higherSentinel/Meshy-Tron/hardware/meshy-tron.pdf

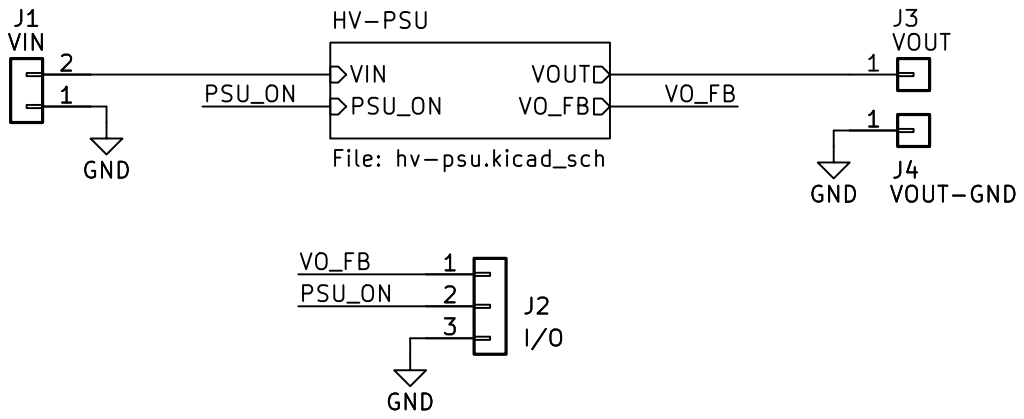
[picture p1: page 1]

File: meshy-tron.kicad_sch Sheet: / AVLabs

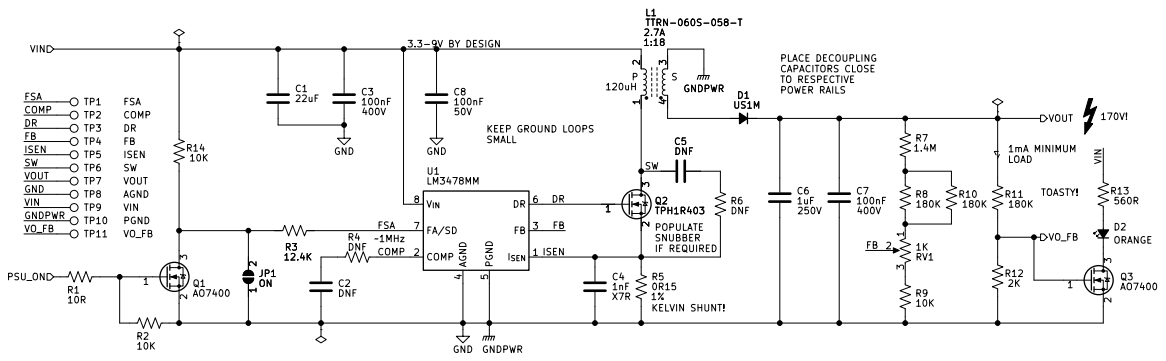
[picture p2: page 2]

File: hv-psu.kicad_sch Sheet: /HV-PSU/ AVLabs
