higherSentinel/Meshy-Tron/hardware/meshy-tron.kicad_pcb

## KiCad design hardware/meshy-tron.kicad_pcb (2022-12-14)

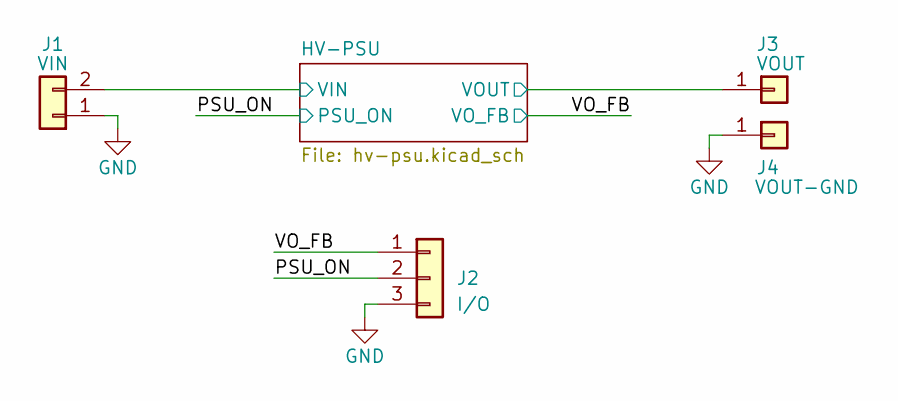
[picture p3: schematic meshy-tron.kicad_sch, Meshytron]

Parts:
J1: VIN; PinHeader_1x02_P2.54mm_Vertical
J2: I/O; PinHeader_1x03_P2.54mm_Vertical
J3: VOUT; PinHeader_1x01_P2.54mm_Vertical
J4: VOUT-GND; PinHeader_1x01_P2.54mm_Vertical

Connections:
/HV-PSU/VIN: J1.2; also elsewhere on the board
/HV-PSU/VOUT: J3.1; also elsewhere on the board
/PSU_ON: J2.2; also elsewhere on the board
/VO_FB: J2.1; also elsewhere on the board
GND: J1.1, J2.3, J4.1; also elsewhere on the board

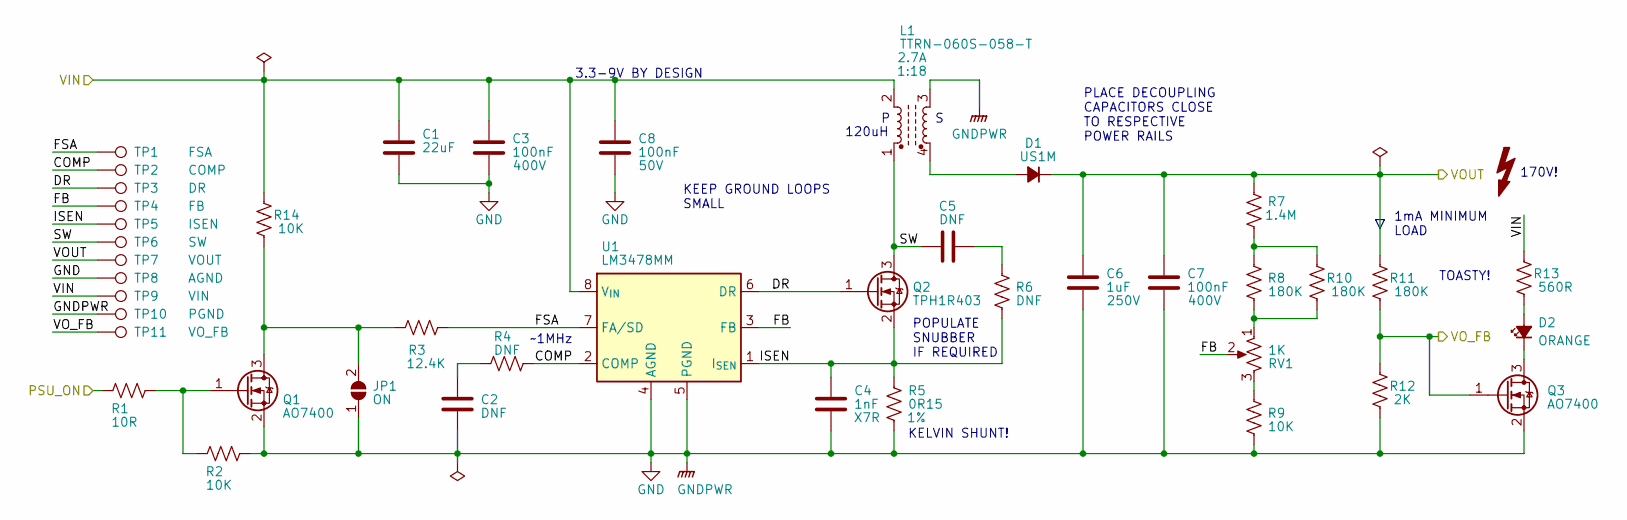
[picture p4: schematic hv-psu.kicad_sch, Meshytron]

Parts:
C1: 22uF; C_0603_1608Metric_Pad1.08x0.95mm_HandSolder; MPN CL31A226KAHNNNE; LCSC C12891
C2, C5: DNF; C_0603_1608Metric_Pad1.08x0.95mm_HandSolder
C3, C7: 100nF; C_1206_3216Metric_Pad1.33x1.80mm_HandSolder; Voltage 400V; MPN FM31X104K251EEG; LCSC C365814
C4: 1nF; C_0603_1608Metric_Pad1.08x0.95mm_HandSolder; MPN CL10B102KB8NNNC; LCSC C1588
C6: 1uF; C_1812_4532Metric_Pad1.57x3.40mm_HandSolder; Voltage 250V; Tolerance X7R; MPN FS43X105K251EGG; LCSC C381468
C8: 100nF; C_0603_1608Metric_Pad1.08x0.95mm_HandSolder; Voltage 50V; MPN 0603B104K500NT; LCSC C30926
D1: US1M; D_SMA_Handsoldering; MPN US1M; LCSC C412437
D2: ORANGE; LED_0805_2012Metric_Pad1.15x1.40mm_HandSolder; MPN SZYY0805O; LCSC C434437
JP1: ON; SolderJumper-2_P1.3mm_Open_RoundedPad1.0x1.5mm
L1: TTRN-060S-058-T; MPN TTRN-060S-058-T
Q1, Q3: AO7400; SOT-323_SC-70_Handsoldering; MPN AO7400-VB; LCSC C879165
Q2: TPH1R403; SOP-ADVANCED; MPN TPH1R403NL; LCSC C83440
R1: 10R; R_0603_1608Metric_Pad0.98x0.95mm_HandSolder; MPN 0603WAF100JT5E; LCSC C22859
R2, R9, R14: 10K; R_0603_1608Metric_Pad0.98x0.95mm_HandSolder; MPN RC0603JR-0710KL; LCSC C99198
R3: 12.4K; R_0603_1608Metric_Pad0.98x0.95mm_HandSolder; MPN RS-03K1242FT; LCSC C310267
R4, R6: DNF; R_0603_1608Metric_Pad0.98x0.95mm_HandSolder
R5: 0R15; R_1206_3216Metric_Pad1.30x1.75mm_HandSolder; Tolerance 1%; MPN RL1206FR-070R15L; LCSC C327070
R7: 1.4M; R_0603_1608Metric_Pad0.98x0.95mm_HandSolder; MPN CR1206F41404G; LCSC C3037104
R8, R10, R11: 180K; R_1210_3225Metric_Pad1.30x2.65mm_HandSolder; MPN FRC1210J184-TS; LCSC C2960705
R12: 2K; R_0603_1608Metric_Pad0.98x0.95mm_HandSolder; MPN 0603WAF2001T5E; LCSC C22975
R13: 560R; R_0603_1608Metric_Pad0.98x0.95mm_HandSolder; MPN 0805W8F5600T5E; LCSC C28636
RV1: 1K; Potentiometer_Bourns_3224W_Vertical; MPN BOURNS 3224W-1-102E; LCSC C50204
TP1: FSA; TestPoint_Pad_D1.0mm
TP2: COMP; TestPoint_Pad_D1.0mm
TP3: DR; TestPoint_Pad_D1.0mm
TP4: FB; TestPoint_Pad_D1.0mm
TP5: ISEN; TestPoint_Pad_D1.0mm
TP6: SW; TestPoint_Pad_D1.0mm
TP7: VOUT; TestPoint_Pad_D1.0mm
TP8: AGND; TestPoint_Pad_D1.0mm
TP9: VIN; TestPoint_Pad_D1.0mm
TP10: PGND; TestPoint_Pad_D1.0mm
TP11: VO_FB; TestPoint_Pad_D1.0mm
U1: LM3478MM; VSSOP-8_3.0x3.0mm_P0.65mm; MPN LM3478MMX/NOPB; LCSC C404045

Connections:
/HV-PSU/COMP: R4.2, TP2.1, U1.2 (COMP)
/HV-PSU/DR: Q2.1 (G), TP3.1, U1.6 (DR)
/HV-PSU/FB: RV1.2, TP4.1, U1.3 (FB)
/HV-PSU/FSA: R3.2, TP1.1, U1.7 (FA/SD)
/HV-PSU/ISEN: C4.1, Q2.2 (S), R5.2, R6.1, TP5.1, U1.1 (I_{SEN})
/HV-PSU/SW: C5.1, L1.1, Q2.3 (D), TP6.1
/HV-PSU/VIN: C1.1, C3.1, C8.1, L1.2, R13.2, R14.2, TP9.1, U1.8 (V_{IN}); also elsewhere on the board
/HV-PSU/VOUT: C6.1, C7.1, D1.1 (K), R7.1, R11.2, TP7.1; also elsewhere on the board
/PSU_ON: R1.2; also elsewhere on the board
/VO_FB: Q3.1 (G), R11.1, R12.2, TP11.1; also elsewhere on the board
GND: C1.2, C2.2, C3.2, C4.2, C6.2, C7.2, C8.2, JP1.1 (A), L1.3, Q1.2 (S), Q3.2 (S), R2.1, R5.1, R9.1, R12.1, TP8.1, TP10.1, U1.4 (AGND), U1.5 (PGND); also elsewhere on the board
unnamed: C2.1, R4.1
unnamed: C5.2, R6.2
unnamed: D1.2 (A), L1.4
unnamed: D2.1 (K), Q3.3 (D)
unnamed: D2.2 (A), R13.1
unnamed: JP1.2 (B), Q1.3 (D), R3.1, R14.1
unnamed: Q1.1 (G), R1.1, R2.2
unnamed: R9.2, RV1.3
unnamed: R8.1, R10.1, RV1.1
unnamed: R7.2, R8.2, R10.2

Notes on the sheet:
TOASTY!
PLACE DECOUPLING CAPACITORS CLOSE TO RESPECTIVE POWER RAILS
KELVIN SHUNT!
~1MHz
170V!
120uH
3.3-9V BY DESIGN
POPULATE SNUBBER IF REQUIRED
1mA MINIMUM LOAD
KEEP GROUND LOOPS SMALL

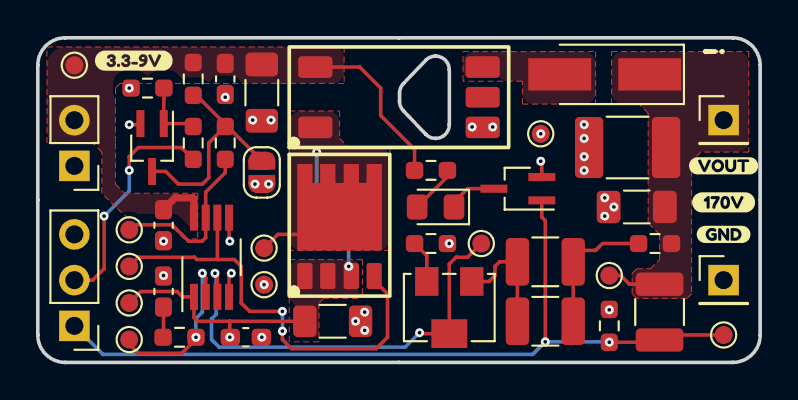
[picture p5: board meshy-tron.kicad_pcb from above]

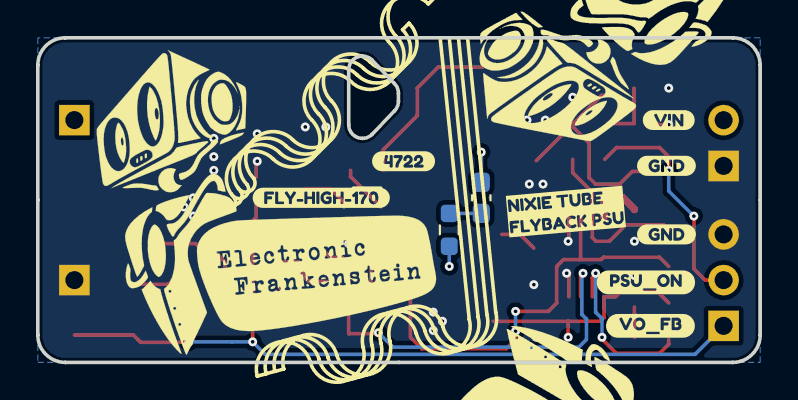
[picture p6: board meshy-tron.kicad_pcb from below]

Board: 2 copper layers, 40.1 x 18.0 mm, 58 parts (10 on the bottom side), 21 nets.

Other parts of the board:
kibuzzard-63828ECC: G***; kibuzzard-63828ECC
kibuzzard-63828EDB: G***; kibuzzard-63828EDB
kibuzzard-63829B28: G***; kibuzzard-63829B28
kibuzzard-63829C5B: G***; kibuzzard-63829C5B
kibuzzard-63829F7F: G***; kibuzzard-63829F7F
kibuzzard-63829F8D: G***; kibuzzard-63829F8D
kibuzzard-63829F70: G***; kibuzzard-63829F70
kibuzzard-63829FA8: G***; kibuzzard-63829FA8
kibuzzard-63829FB9: G***; kibuzzard-63829FB9
kibuzzard-638295AD: G***; kibuzzard-638295AD
kibuzzard-638295D5: G***; kibuzzard-638295D5
kibuzzard-63829606: G***; kibuzzard-63829606
